gmdb22/SIGNYALES/docs/Signyales_Software_Requirements.docx

Software Requirements and System Design

This section identifies the software components required to implement the Signyales system, organized by the physical layer on which each component runs. The system is composed of four cooperating software layers: glove-node firmware, receiver-dongle firmware, central hub software on the Raspberry Pi 4, and an offline machine learning development pipeline used to produce the TinyML model deployed at runtime. Each layer is described below, followed by a consolidated software requirements matrix.

1. Glove Node Firmware (ESP32-S3, ×2)

Each of the two wearable units requires embedded firmware responsible for reading raw sensor data and transmitting it wirelessly to the receiver dongle. This firmware constitutes the first stage of the data pipeline and directly determines the fidelity of the gesture data available to the recognition model downstream.

- Sensor sampling routines for the flex sensors (finger bend/handshape) and the accelerometer/IMU (hand orientation and motion), read via the ESP32-S3's ADC and I2C/SPI peripherals.
- Signal conditioning logic (debouncing and noise smoothing) applied before transmission, to reduce jitter introduced by raw ADC readings.
- ESP-NOW packet construction and transmission, including a defined payload structure for bimanual sensor data.
- Power management routines (sleep/wake cycling) to extend operating time on the glove's battery supply.

Recommended development environment: Arduino IDE or PlatformIO with the ESP-IDF framework, written in Embedded C++.

2. Receiver Dongle Firmware (ESP32)

The receiver dongle bridges the wireless glove network and the wired connection to the Raspberry Pi. Its firmware must reliably reconcile two independent, asynchronously-arriving data streams before forwarding a single combined stream downstream.

- ESP-NOW receive handlers for both the left-glove and right-glove transmissions.
- Packet synchronization logic to align left- and right-hand samples that may arrive with a slight timing offset, so the model receives one coherent bimanual frame.
- UART/Serial forwarding of the synchronized data to the Raspberry Pi 4.
- Basic error handling for dropped, corrupted, or out-of-order packets.

3. Central Hub Software (Raspberry Pi 4)

The Raspberry Pi 4 is the system's central processing unit and requires the most extensive software stack, covering data ingestion, inference, translation, and speech output.

- A serial listener to ingest the UART stream from the receiver dongle and parse it into structured sensor frames.
- A TinyML inference pipeline that loads the trained, quantized model and feeds it sliding windows of live sensor data to produce gesture predictions.
- Gesture-to-text mapping logic that converts recognized handshapes/motions into corresponding Filipino Sign Language words or phrases.
- An offline text-to-speech engine (e.g., a locally-hosted lightweight neural TTS or a conventional engine such as eSpeak/Festival) to generate audio output without any dependency on cloud APIs, consistent with the project's offline-first scope.
- Minimal status feedback (e.g., console or LED-based) in place of a mobile application or graphical interface, which are explicitly excluded from the project scope.

Recommended development environment: Python 3, developed and tested in Visual Studio Code.

4. Machine Learning Development Pipeline (Offline)

Unlike the three layers above, this software does not run at translation time. It is used beforehand to produce the trained model file that the Raspberry Pi loads for inference, and it must be revisited whenever the gesture vocabulary is expanded or the model is retrained.

- Data collection scripts to log labeled sensor sequences per gesture, forming the training dataset.
- Model training code, developed in Jupyter Notebook, using a framework such as TensorFlow/Keras.
- Model compression and optimization (quantization, pruning, and/or knowledge distillation) to fit the model within the memory and compute limits of the target hardware, using TensorFlow Lite Micro or an equivalent toolchain.
- A basic versioning workflow for trained models, since the deployed model is static once loaded and cannot adapt in real time (noted as a limitation of the study).

5. Testing, Evaluation, and Research Instrumentation

These tools support the data-gathering and evaluation procedures described in the Research Methodology and are not part of the deployed system, but are required to produce the quantitative results reported in Chapters IV and V.

Component | Software / Tool | Purpose
Data collection | Google Forms | Captures respondent demographic data, communication tools used, and post-testing feedback.
Data analysis | Google Sheets | Computes frequency, percentage, mean, weighted mean, and standard deviation from gathered data; generates charts.
Accuracy logging | Custom scripts / spreadsheet | Records the Recognition Accuracy Matrix (actual gesture vs. system output) during alpha and field testing.
Performance logging | Custom scripts / spreadsheet | Records packet delivery ratio, sensor response time, and battery performance for the Technical Performance Checklist.

Consolidated Software Requirements Matrix

Component | Software / Tool | Purpose
Glove firmware | Arduino IDE / PlatformIO (ESP-IDF), Embedded C++ | Sensor sampling and ESP-NOW transmission on each glove.
Receiver firmware | Arduino IDE / PlatformIO (ESP-IDF), Embedded C++ | ESP-NOW reception, packet sync, and UART forwarding.
Hub application | Python 3, Visual Studio Code | Serial ingestion, TinyML inference, gesture-to-text mapping.
Speech output | Offline TTS engine (e.g., eSpeak/Festival or local neural TTS) | Converts translated text into audio without internet dependency.
Model training | Jupyter Notebook, TensorFlow/Keras | Trains the gesture recognition model on collected sensor data.
Model optimization | TensorFlow Lite Micro (or equivalent) | Quantizes/compresses the trained model for edge deployment.
Data gathering | Google Forms | Collects respondent and feedback data.
Data analysis | Google Sheets | Computes statistical measures and visualizations from gathered data.

Note: The proposal's current Software Used section names Jupyter Notebook and Visual Studio Code but does not specify the firmware framework (Arduino IDE vs. ESP-IDF/PlatformIO) or the offline text-to-speech engine to be used. Both should be finalized and stated explicitly, as they are load-bearing implementation decisions likely to be raised during panel review.
