gmdb22/SIGNYALES/docs/Signyales_Research_Instruments.docx

Research Instrument

Signyales User Evaluation Questionnaire

This instrument is designed for administration through Google Forms immediately after a participant completes a hands-on testing session with the device. It is organized into three parts: respondent profile, a 5-point Likert-scale evaluation, and open-ended feedback. Each item below is written exactly as it should appear as a Google Forms question, with its intended question type noted in brackets so it can be entered directly without rewriting.

Part I. Respondent Profile

Google Forms question type: “Multiple choice” for each item below.

1. Age

- Under 18
- 18–25
- 26–35
- 36–45
- 46 and above

2. Sex

- Male
- Female
- Prefer not to say

3. Hearing status

- Deaf
- Hard of hearing
- Hearing

4. Filipino Sign Language (FSL) proficiency

- Beginner
- Intermediate
- Advanced / Fluent

5. Have you used an assistive communication device or app before?

- Yes
- No

Part II. Device Evaluation

Google Forms question type: “Linear scale,” 1 to 5, with 1 labeled “Strongly Disagree” and 5 labeled “Strongly Agree.” Group the items under each heading below as separate Google Forms “sections” for readability, or present them as one linear-scale grid question per group if the form builder in use supports grids.

A. Perceived Usefulness

1. The device helps me communicate more effectively using Filipino Sign Language.

2. Using this device improves my ability to interact with people who do not know sign language.

3. The device provides accurate translations of the signs I perform.

B. Perceived Ease of Use

4. Learning to use the device was easy for me.

5. The device is comfortable to wear for extended periods.

6. I can easily understand how to calibrate and operate the device.

C. Recognition and Output Quality

7. The device recognized my gestures quickly.

8. The spoken output was clear and understandable.

9. The device worked reliably throughout my testing session.

D. Satisfaction and Behavioral Intention

10. I would be willing to use this device regularly if it were available.

11. I would recommend this device to others who use sign language.

12. Overall, I am satisfied with the device's performance.

Part III. Open-Ended Feedback

Google Forms question type: “Paragraph.”

1. What did you like most about using the device?

2. What difficulties or frustrations did you encounter?

3. What improvements would you suggest?

Scoring and Interpretation

Part II responses are scored on their face value (1–5) and summarized per item as a weighted mean, using the standard 5-point Likert interpretation scale below. This range table is what Signyales_Survey_Analysis_Template.xlsx uses to automatically label each item's weighted mean once responses are entered.

Weighted Mean Range | Verbal Interpretation | Practical Reading
4.20 – 5.00 | Strongly Agree | Highly acceptable
3.40 – 4.19 | Agree | Acceptable
2.60 – 3.39 | Neutral | Moderately acceptable
1.80 – 2.59 | Disagree | Less acceptable
1.00 – 1.79 | Strongly Disagree | Not acceptable

Administering This Instrument

- Build this as a single Google Form with the three parts above as separate sections, in order.
- Set Part I and Part II items to required; leave Part III optional, since forcing detailed written feedback can reduce completion rates without improving its quality.
- Under Google Forms' Responses tab, link the form to a Google Sheet (“Create Spreadsheet”) so responses land in a single sheet automatically as participants submit.
- Export or copy that response sheet's data into Signyales_Survey_Analysis_Template.xlsx's Raw Responses tab, matching column order, to get the frequency tables, weighted means, and verbal interpretations automatically.
- Administer this immediately after each participant's testing session (see the Field Testing Procedure), while the experience is still fresh, rather than collecting it separately afterward.
