gmdb22/SIGNYALES/docs/Signyales_System_Implementation.docx

System Implementation and Integration

This section describes how the four software layers identified earlier in this chapter were implemented and, critically, how each layer's output was verified against the layer that consumes it, rather than each being developed and tested in isolation. The pipeline is: glove node firmware (×2) → receiver dongle firmware → Raspberry Pi 5 hub application → offline TinyML training pipeline, whose output feeds back into the hub. Every boundary between two layers is defined by an explicit, versioned data contract, which is what made it possible to verify integration before final hardware assembly was complete.

1. Glove Node Firmware

Each glove (ESP32-S3) samples five flex sensors and a six-axis IMU at 50 Hz, applies exponential moving-average smoothing, normalizes flex readings against a per-finger calibration stored in flash, and transmits the result over ESP-NOW as a fixed-layout packet (glove_packet_t). A stored calibration routine (triggered over Serial) maps each finger's raw ADC range to a consistent 0–4095 scale, correcting for sensor-to-sensor manufacturing variance that would otherwise appear in the training data as noise unrelated to the gesture itself.

2. Receiver Dongle Firmware

The receiver (ESP32) receives both gloves' ESP-NOW transmissions, validates each packet's checksum, and forwards a combined bimanual frame to the Raspberry Pi over a dedicated UART every 20 ms — independent of whether new glove packets have just arrived. This "sample-and-hold" design was chosen deliberately over waiting for a matched left/right pair: waiting would stall the entire pipeline on a single dropped packet from either hand. Each forwarded frame instead carries a validity flag per hand indicating whether that hand's data is fresh (received within the last 30 ms) or stale, leaving the decision of how to treat stale data to the Pi hub rather than making that decision unilaterally on the receiver.

3. Raspberry Pi 5 Hub Application

The hub (Python, running on a Raspberry Pi 5, 4GB) parses the receiver's UART stream, extracts a 22-value feature vector per frame, accumulates a 1-second sliding window (50 samples), and runs TinyML inference on that window roughly ten times per second. Raw predictions are debounced — a gesture is only accepted once it has been predicted consistently, above a confidence threshold, for several consecutive inferences — before being converted to on-screen text and spoken aloud through an offline text-to-speech engine. The hub is explicitly designed to run correctly before a trained model exists: with no model present, every other stage (serial parsing, windowing, debouncing, speech output wiring) still executes normally, which allowed this layer to be built and tested in parallel with, rather than strictly after, the training pipeline.

4. TinyML Training Pipeline

A companion data collection tool records labeled gesture repetitions using the hub's own serial-parsing and feature-extraction code, guaranteeing that training data is built from the identical feature vector the hub uses at inference time. Each variable-length repetition is resampled to a fixed 50-frame window via linear interpolation. A Jupyter Notebook then trains a compact 1D convolutional network on the collected windows, evaluates it (producing the Recognition Accuracy Matrix and per-class report), and exports three artifacts directly into the hub's model directory: the trained model in TensorFlow Lite format, a label list, and the per-feature normalization values used during training.

Integration Contracts

Three explicit data contracts connect these layers. Each is implemented as a shared definition copied verbatim between the two sides it connects, rather than re-derived independently on each side — the latter is how firmware and application code quietly drift out of agreement over time.

Contract | Connects | What it fixes
packet.h | Glove firmware ↔ Receiver firmware | Byte layout of one hand's sensor packet, including the additive checksum used to detect transmission corruption.
frame.h | Receiver firmware ↔ Pi hub (Python) | Byte layout of the combined bimanual frame and its UART framing (sync bytes + length prefix).
Feature order + model artifacts | Pi hub ↔ Training pipeline | The 22-value feature order (left flex, right flex, left accel/gyro, right accel/gyro) and the three files (model.tflite, labels.json, scaler.json) the hub expects a trained model to be delivered as.

Verification Performed

Each contract above was verified programmatically rather than assumed correct by inspection, since a struct-layout mismatch between firmware and Python does not raise an error anywhere in the pipeline — it simply produces incorrect values silently. The following checks were run and passed prior to final hardware integration:

- A frame round-trip test packs a synthetic combined_frame_t using the exact struct layout the receiver firmware uses, confirms the Pi hub's Python parser decodes every field back correctly, and confirms a deliberately corrupted byte is correctly rejected by the checksum check.
- The full hub pipeline (serial parsing, windowing, inference, debouncing, text-to-speech wiring) was run end-to-end using a synthetic data source, with and without a trained model present, confirming graceful behavior in both cases rather than a crash when a model is not yet available.
- A complete synthetic training run was carried out: a small labeled dataset was generated, trained into a model through the actual training pipeline, exported through the actual export code, and the resulting model.tflite/labels.json/scaler.json were loaded back through the hub's own model-loading code — not a separate test harness. The hub correctly classified a held-out example, confirming the full collection-to-deployment loop functions correctly before any real gesture data has been collected.

Testing and Evaluation Tooling

Three additional tools support the evaluation phase described elsewhere in this chapter: an accuracy logger that prompts a tester through a randomized sequence of named gestures and produces the Recognition Accuracy Matrix (as a CSV table and a plotted figure) along with mean and standard deviation of recognition latency; a performance logger that reports packet delivery ratio and recognition latency over an extended session; and a lower-level link logger that, using a secondary connection to the receiver dongle, isolates packet loss occurring specifically on the ESP-NOW hop between the gloves and the receiver. Battery performance is recorded manually, alongside a performance-logger session, since runtime under continuous use is a physical measurement rather than one the software pipeline can observe on its own.

Design Decision: Direct TTS Invocation vs. File-Based Handoff

The proposal's original architecture describes the recognized gesture being written to a text file, which a separate text-to-speech program then reads and speaks. The implemented system instead calls the text-to-speech engine directly from within the same recognition pipeline, as a function call rather than a file handoff between two separate programs. This was a deliberate simplification rather than an oversight: a file-based handoff introduces synchronization risks that do not otherwise exist — a reader process that is not running when a gesture fires, a file read before a write has fully flushed, or the two programs falling out of step with one another. None of these failure modes are possible in a direct-call design, since there is nothing to desynchronize. The two approaches are functionally equivalent in output — a recognized gesture is still converted to spoken audio — and the simpler design was chosen specifically because it removes an entire category of inter-process failure for a single-device system where no other component needs to read the recognized text independently.

Known Integration Risks Not Yet Verified

The verifications above establish that the software layers agree with one another given their documented contracts. They do not yet establish real-world behavior, which depends on hardware not exercised in this phase:

- Firmware has not been compiled and flashed against real ESP32-S3/ESP32 hardware — verification so far is limited to static syntax checks, since no ESP32 toolchain was available in the development environment used for this phase.
- The UART wiring between the receiver and the Pi 5, including the disable-bt configuration required to free the PL011 UART, has not been tested on physical hardware.
- All training and inference verification used synthetic data; no real flex-sensor or IMU data has been collected or trained on yet, so real-world recognition accuracy remains unknown until field testing begins.
- Battery performance and physical range of the ESP-NOW link have not been measured.
