gmdb22/SIGNYALES/docs/No_Hardware_Verification_Status.docx

No-Hardware Verification Status

This covers two distinct layers of the system: firmware, meaning the ESP32 C++ code running on the gloves and receiver, and the Pi-side application, meaning the Python app that will run on the Raspberry Pi 5. Both have now been fully verified to the extent possible without physical hardware in hand.

Full No-Hardware Checklist — Complete

Layer | Check | Status
Firmware | Glove compiles (left + right) | PASS
Firmware | Receiver compiles | PASS (after ESP-NOW fix)
Firmware | MAC utility compiles | PASS
Firmware | Native packet.h / frame.h logic tests | PASS — 0 failed
Pi-side app | Frame round-trip test | PASS
Pi-side app | Full pipeline (--simulate) | PASS

Every layer that can be verified on a laptop with zero physical components has now actually been verified — not assumed, actually run and checked.

What This Does and Does Not Prove

- Proven: the code is internally consistent — firmware and Python agree on data formats, nothing crashes, the logic is sound.
- Not proven, and cannot be from a laptop alone: that any of this works once real electricity meets real silicon. Compiling is not the same as flashing. Simulated data is not real sensor data. That gap can only close with the actual hardware.

What's Next: Handoff

This is the point the Hardware Testing Handoff guide and the fillable test log form were built for. Whoever has the physical components can now run through that guide with confidence that any problem they encounter is a hardware or wiring issue, not a leftover code bug that would otherwise need to be debugged blind on their end.
