gmdb22/SIGNYALES/docs/Signyales_Field_Testing_Procedure.docx

Field Testing Procedure

Step-by-Step Protocol for Participant Testing Sessions

This procedure ties together everything built in earlier phases — the assembled hardware, the accuracy and performance logging tools, and the research instrument — into a single repeatable session that can be run with each participant. Following the same sequence for every participant is what makes results across participants comparable in Chapter IV.

1. Purpose

To evaluate the system's gesture recognition accuracy, technical performance, and user acceptability under real, hands-on use by actual members of the target user group, rather than relying solely on the synthetic verification described in the System Implementation and Integration section.

2. Participants

- Recruit participants who are Deaf, hard of hearing, or fluent/intermediate FSL signers, per the study's target population — recruiting only hearing non-signers would not test what the system is actually meant to do.
- A minimum of 10–15 participants is a reasonable starting point for a capstone-scale evaluation; more strengthens the statistical basis of Chapter IV but is bounded by realistic recruitment access and testing time.
- Obtain informed consent (and parental/guardian consent plus the minor's own assent if any participant is under 18) before testing begins. State plainly that participation is voluntary and can be stopped at any time without consequence.

3. Materials Checklist

Item | Source
Both gloves, calibrated and charged | See Hardware Assembly Guide + glove firmware README calibration routine
Receiver dongle, wired to the Pi | See Hardware Assembly Guide, Receiver ↔ Pi wiring diagram
Raspberry Pi 5, powered, hub application ready to run | signyales_pi_hub
A trained model in signyales_pi_hub/model/ | signyales_training — confirm with `python -m signyales_hub.main -v` before the session that it reports a loaded model, not the “no usable model” warning
Speaker connected and audio-tested | Hardware Assembly Guide
Laptop running accuracy_logger.py / performance_logger.py | signyales_pi_hub/tools
Google Form (from the Research Instrument) open and ready | Signyales_Research_Instruments.docx
Printed or digital informed consent form | Prepared separately per your institution's ethics requirements
Stopwatch or phone timer (backup timing reference) | N/A

4. Pre-Session Setup (before the participant arrives)

1. Fully charge both gloves and confirm calibration is current — recalibrate if a different wearer's hand size differs noticeably from the last calibration.

2. Power on the receiver and Pi, and run `python -m signyales_hub.main --simulate --no-tts -v` briefly to confirm the software stack starts cleanly before switching to the real hardware.

3. Run the real (non-simulated) hub briefly with a team member wearing the gloves to confirm end-to-end recognition works before the participant arrives — debugging hardware issues during a participant's session wastes their time and can affect their impression of the system.

4. Prepare a quiet, reasonably well-lit testing area free of significant electromagnetic interference that could affect the 2.4GHz ESP-NOW link (e.g., away from busy Wi-Fi access points where practical).

5. Session Protocol (per participant)

1. Welcome the participant, explain the purpose of the study in plain terms, and obtain signed informed consent before proceeding.

2. Record the participant's assigned ID (do not use their name in any data file) and have them complete Part I (Respondent Profile) of the Google Form.

3. Fit both gloves and briefly demonstrate one or two gestures yourself so the participant sees what a completed sign looks like to the system.

4. Give the participant a short practice period (2–3 minutes) with the gloves on, performing a few gestures freely with live feedback, before formal data collection begins — this reduces first-attempt unfamiliarity from contaminating the accuracy results.

5. Run the Recognition Accuracy trials: `python tools/accuracy_logger.py --gestures <list> --trials <N> --model-dir model --out results/<participant_id>_accuracy`. Follow the on-screen prompts exactly as they appear — do not skip or reorder trials, since randomized order is what protects the results from practice-effect bias.

6. Immediately after the accuracy trials, run a performance logging session covering a few minutes of freer, more natural device use: `python tools/performance_logger.py --model-dir model --duration <seconds> --out results/<participant_id>_perf`.

7. Have the participant remove the gloves and complete Part II and Part III of the Google Form while the experience is still fresh.

8. Thank the participant and answer any questions about the study or the device.

6. Data Handling

- Store each participant's accuracy_logger.py and performance_logger.py output files under a results/ directory named by participant ID, not by name.
- Copy Google Form responses into Signyales_Survey_Analysis_Template.xlsx's Raw Responses sheet after each session, or in a batch at the end of the testing phase — either works, since the sheet's formulas recompute automatically either way.
- Keep the informed consent forms separately from the numerical data, linked only by participant ID, consistent with standard practice for protecting participant confidentiality.

7. After All Sessions Are Complete

- Aggregate all participants' accuracy_logger.py CSVs into a single combined Recognition Accuracy Matrix for Chapter IV, rather than reporting each participant's matrix in isolation.
- Review the Likert Analysis sheet's per-item and overall weighted means and verbal interpretations — these map directly onto the acceptability discussion in Chapter IV.
- Review open-ended responses (Part III) for recurring themes — these often explain *why* a particular quantitative result came out the way it did, and are worth quoting selectively in the discussion.
- Cross-reference low-accuracy gestures against performance_logger.py's packet delivery ratio for the same sessions — a gesture that was consistently misrecognized for one participant but not others may point to a fit/calibration issue rather than a model weakness.
