gmdb22/SIGNYALES/docs/testing_handoff/signyales_test_log.html

SIGNYALES · HARDWARE TEST LOG

# Log your results stage by stage

Fill this in as you go through the testing guide. At the end, generate a clean summary you can copy and send back.

Your name

Date

Generate summary

Summary — copy this and send it back Copy to clipboard

Saved automatically on this device as you type — nothing is sent anywhere until you copy and send it yourself.
