gmdb22/SIGNYALES/pi-side/requirements-testing.txt

# Only needed to run tools/accuracy_logger.py's plotted confusion matrix.
# The deployed hub application (signyales_hub) does not need this.
matplotlib>=3.7
