gmdb22/SIGNYALES/(commit log)

2026-09-30 ITS TIME BRAH ACTUALLY LOCKIN WE DO BUG FIXES AND SHIT
    [accuracy_logger.py, benchmark_inference.py, collect_gesture.py, config.h, config.py, frame.h, gesture_debounce.py, get_mac_address.ino]
2026-10-03 Note firmware testing:
    receiver compilation failed
    apparently the logic tests passed but bash command doesnt work and ill need to understand this deeper
    [benchmark_inference.py, config.py, gesture_debounce.py, main.py, model_runtime.py]
2026-10-06 added gui testing file
    [Signyales_Python_Software_Inventory.xlsx, Signyales_Survey_Analysis_Template.xlsx]
2026-10-12 latest version before chat migration
    [Signyales_Data_Collection_Tracker.xlsx]
